1fahadaloufi/GuitarVillains/docs/Difficulty_Selection_FSM.png

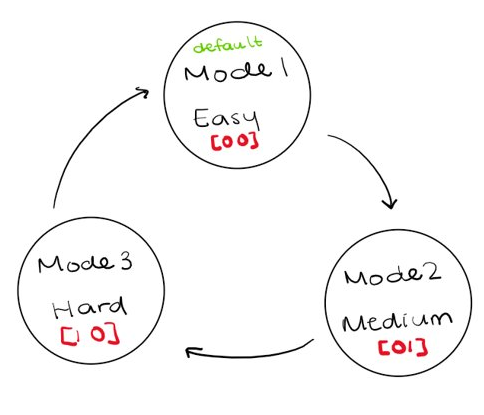
docs/Difficulty_Selection_FSM.png
