1fahadaloufi/GuitarVillains/docs/Mode_FSM.png

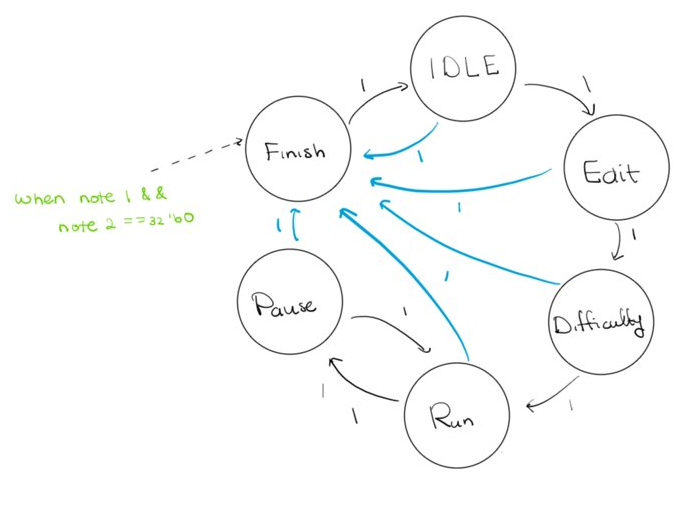
docs/Mode_FSM.png
