1fahadaloufi/GuitarVillains/docs/Component RTL- Scores Counter RTL.png

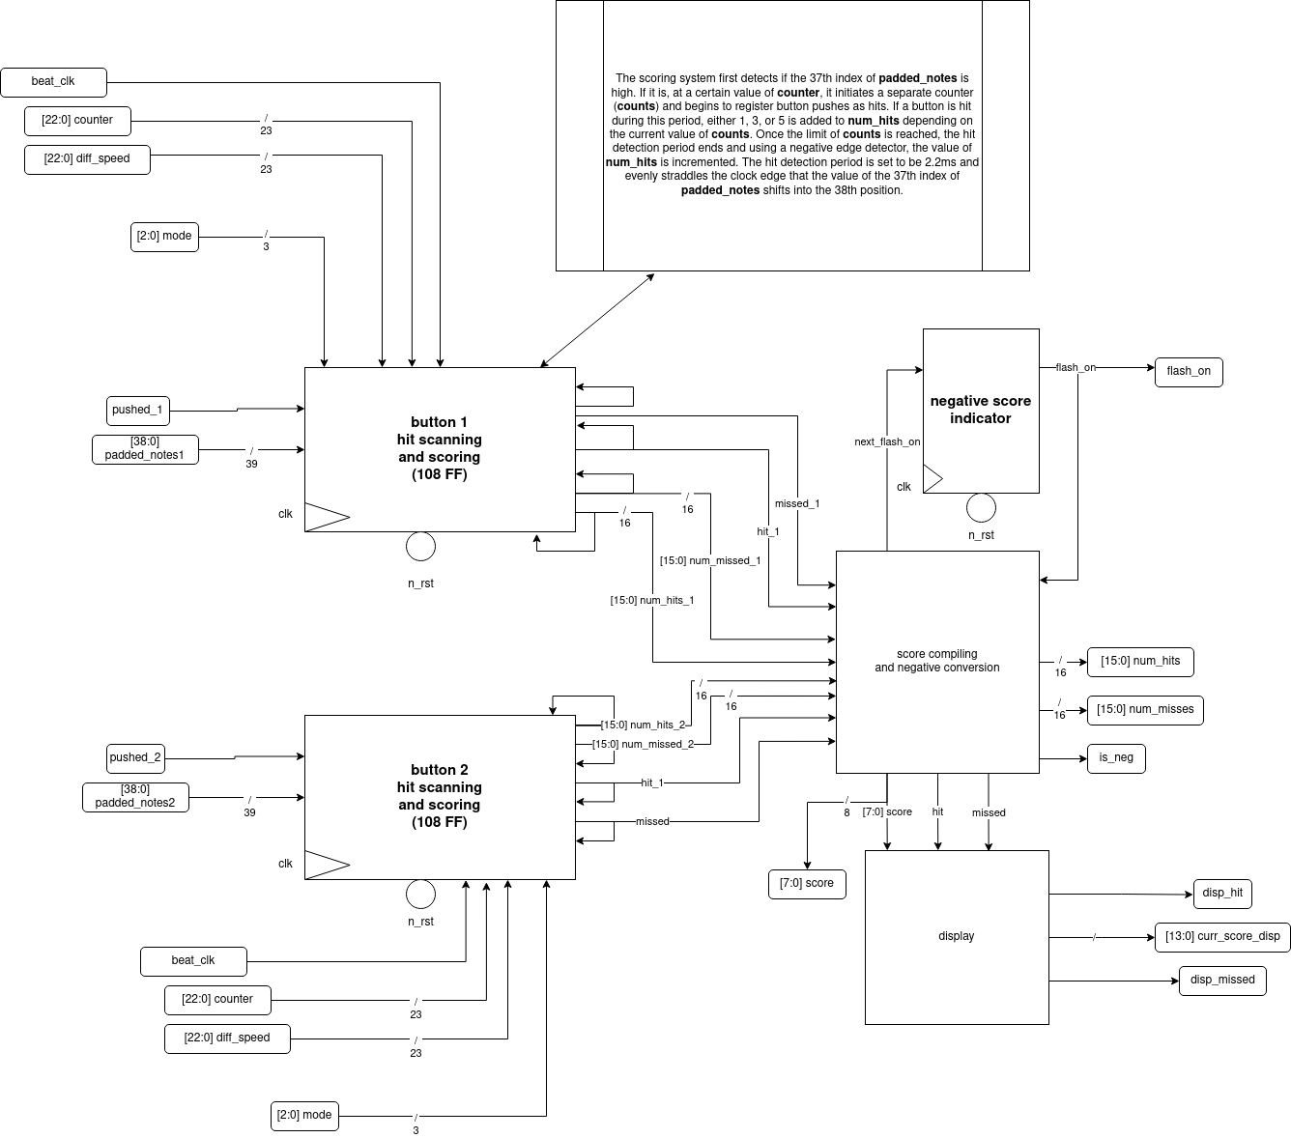
docs/Component RTL- Scores Counter RTL.png
