1fahadaloufi/GuitarVillains/docs/Component RTL-Clock Divider RTL.png

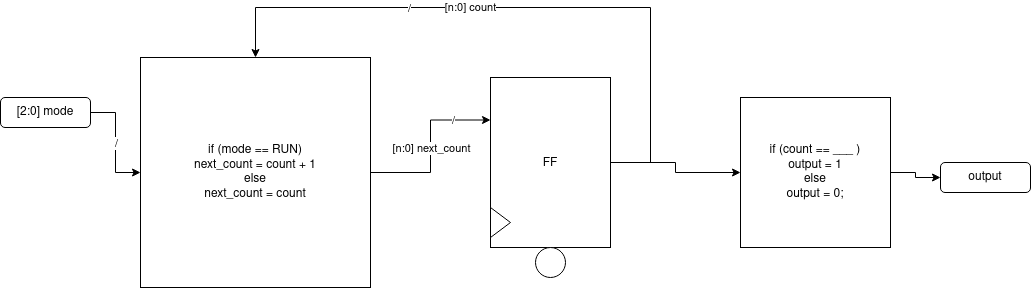
docs/Component RTL-Clock Divider RTL.png
