1fahadaloufi/GuitarVillains/docs/Component RTL-Difficulty Control FSM.png

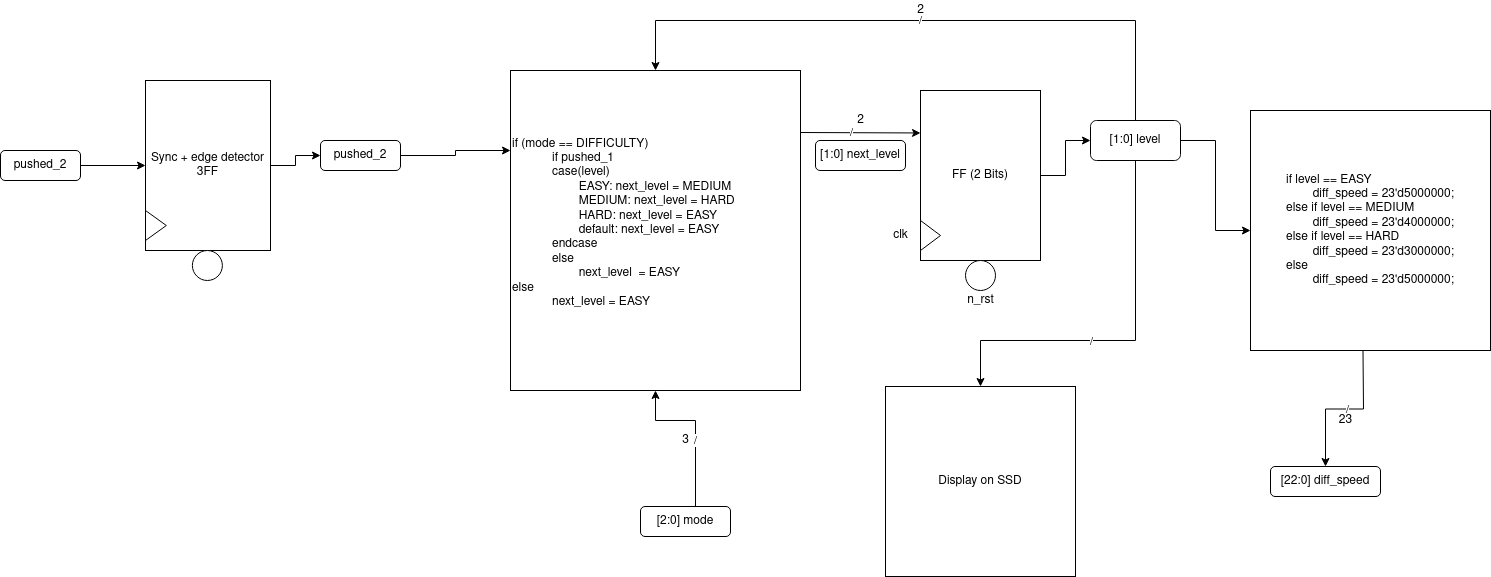
docs/Component RTL-Difficulty Control FSM.png
