1fahadaloufi/GuitarVillains/docs/Component RTL-Editor RTL.png

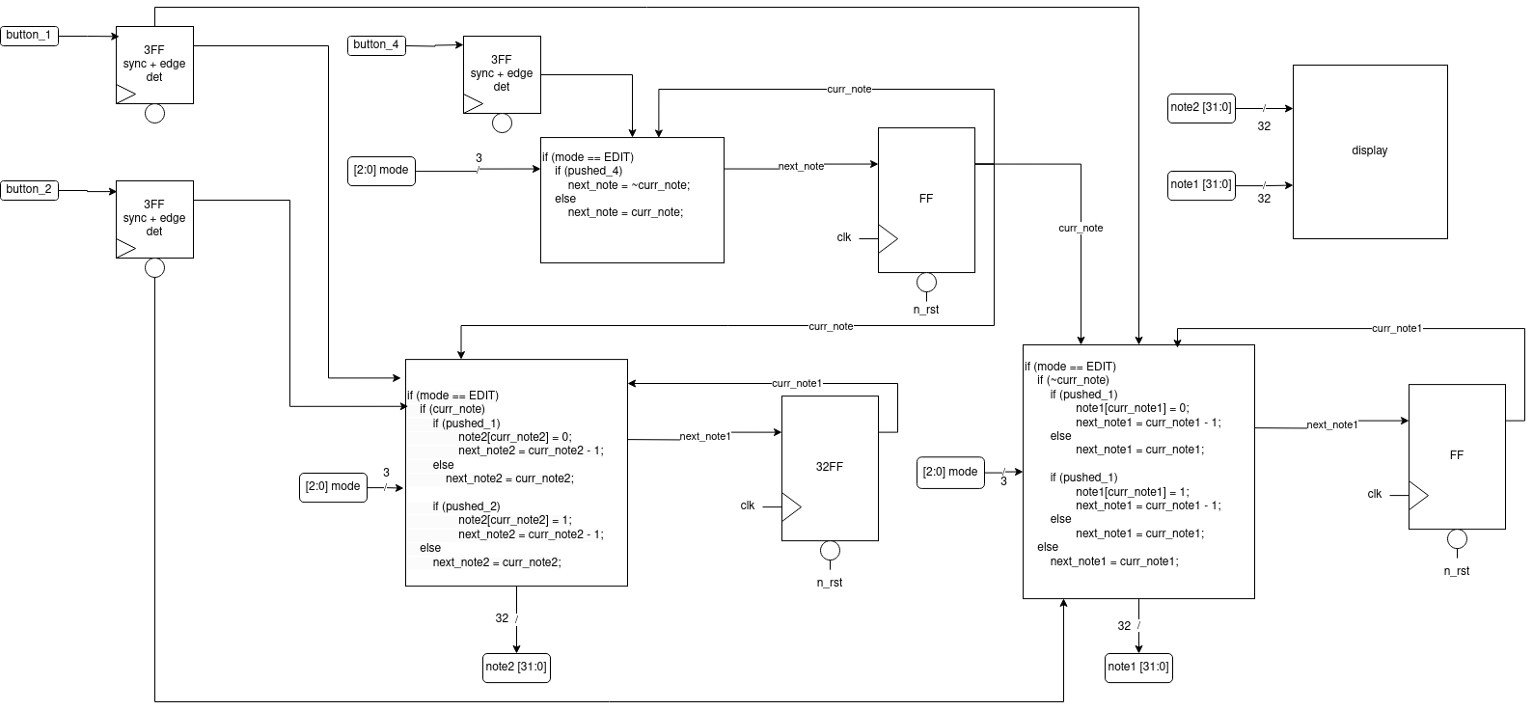
docs/Component RTL-Editor RTL.png
