1fahadaloufi/GuitarVillains/docs/Component RTL-Finish Counter RTL.png

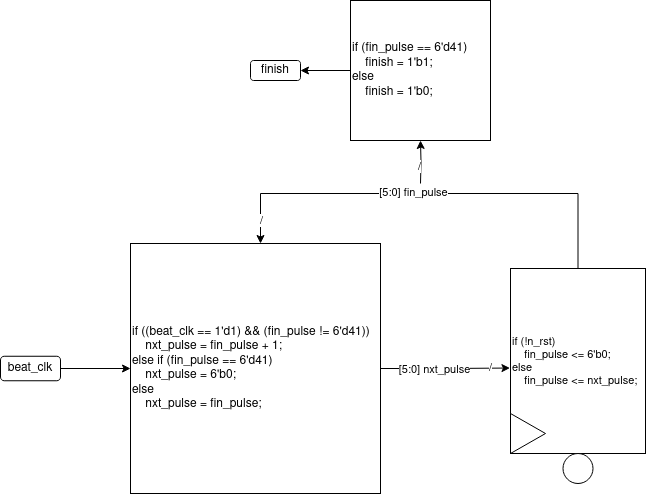
docs/Component RTL-Finish Counter RTL.png
