1fahadaloufi/GuitarVillains/docs/Component RTL-Highest Score RTL.drawio.png

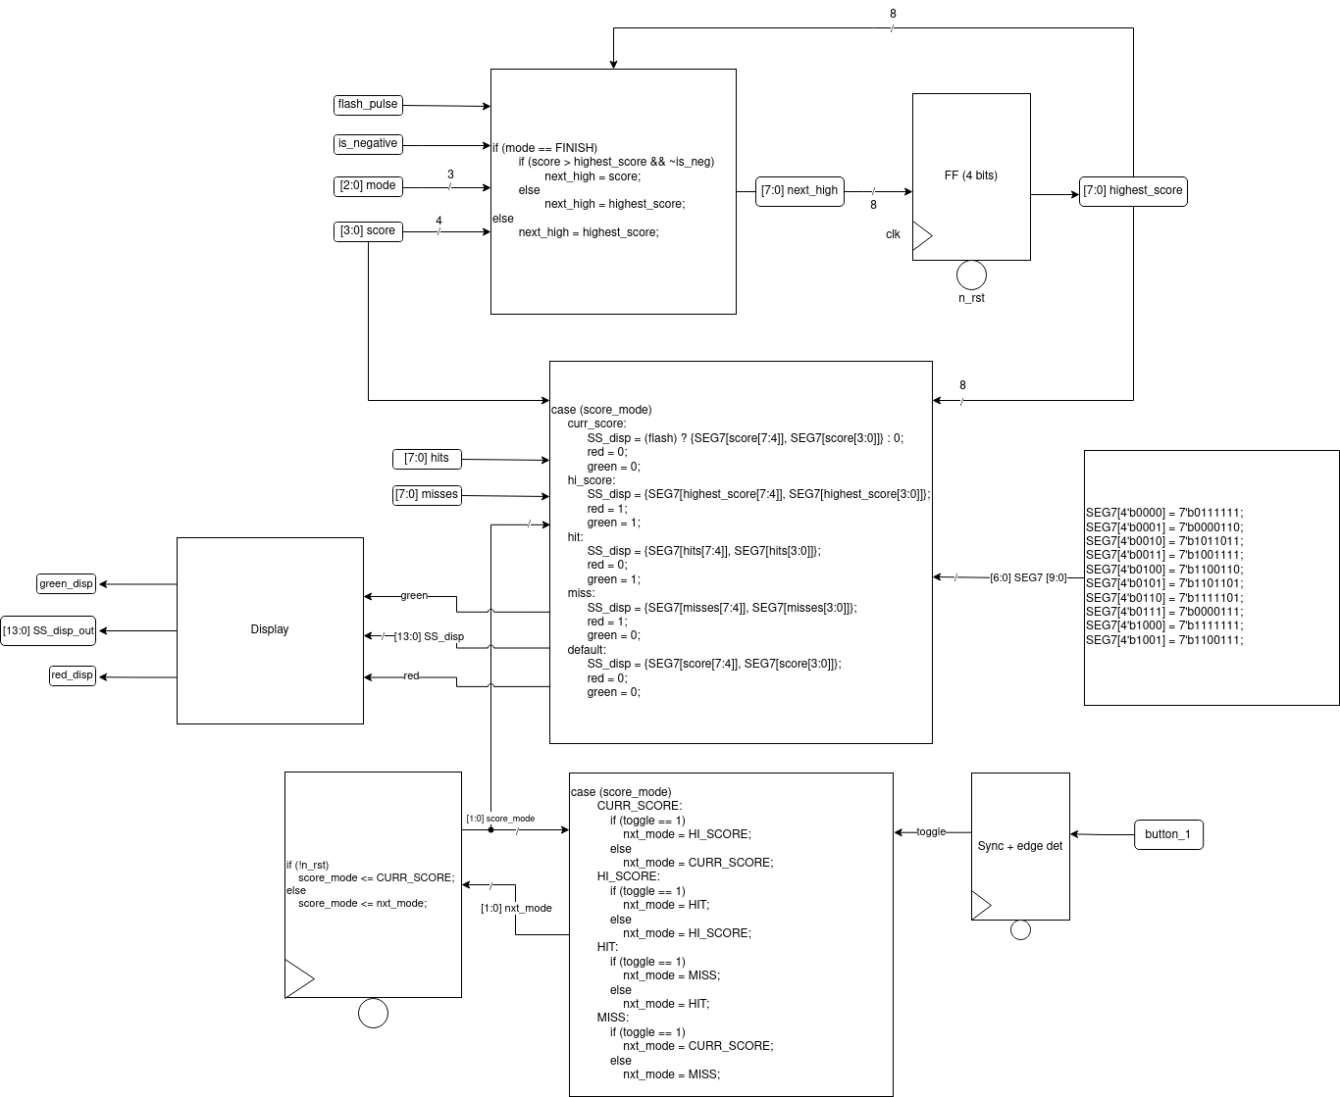
docs/Component RTL-Highest Score RTL.drawio.png
