1fahadaloufi/GuitarVillains/docs/Component RTL-Notes Shift Register RTL.drawio.png

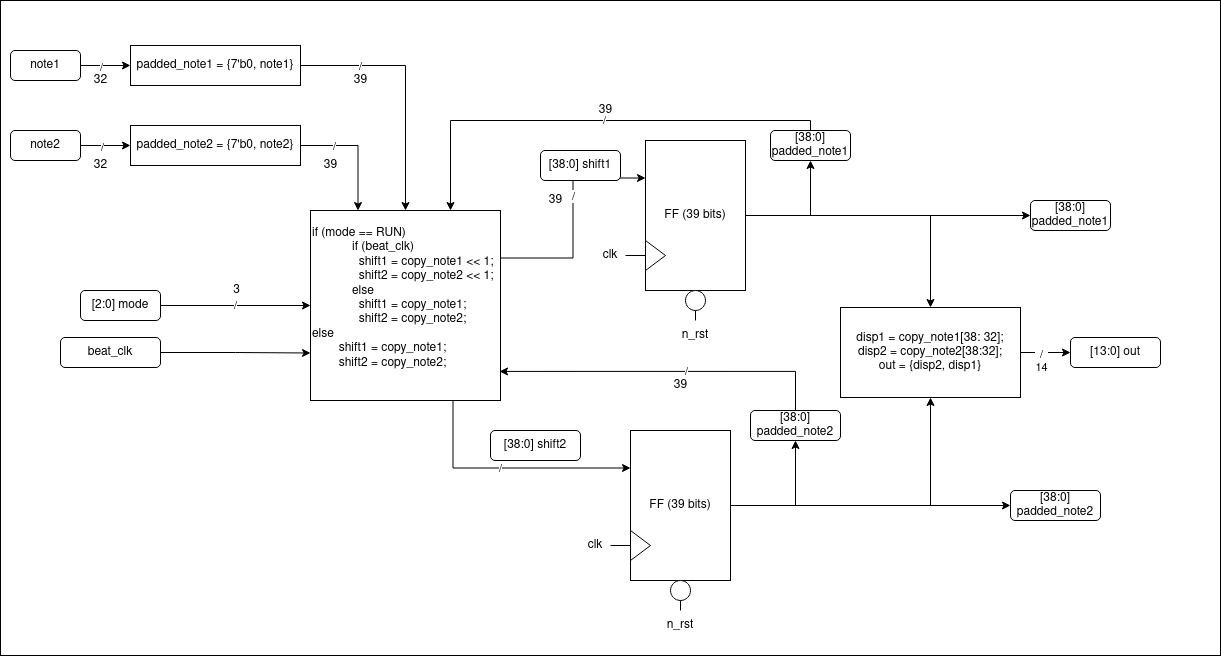
docs/Component RTL-Notes Shift Register RTL.drawio.png
