1fahadaloufi/GuitarVillains/docs/Component RTL-State FSM RTL.png

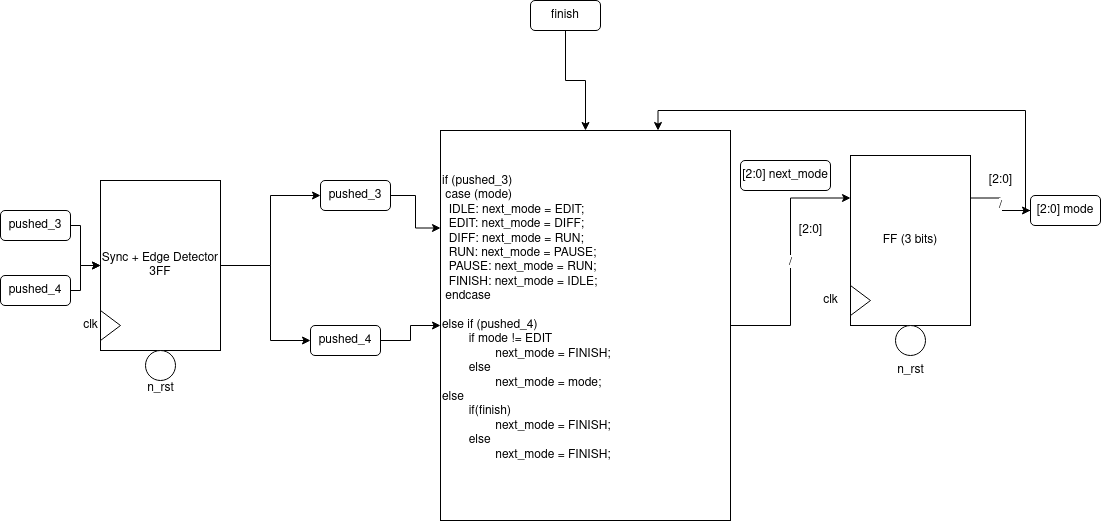
docs/Component RTL-State FSM RTL.png
