1fahadaloufi/GuitarVillains/(commit log)

2023-06-23 slightly bigger window and switched to 12MHz
2023-07-06 Update README.md
    edited pin mappings
